damianjarczok/Wzmacniacz-klasy-D-z-modulem-BT/20231201_183953.jpg

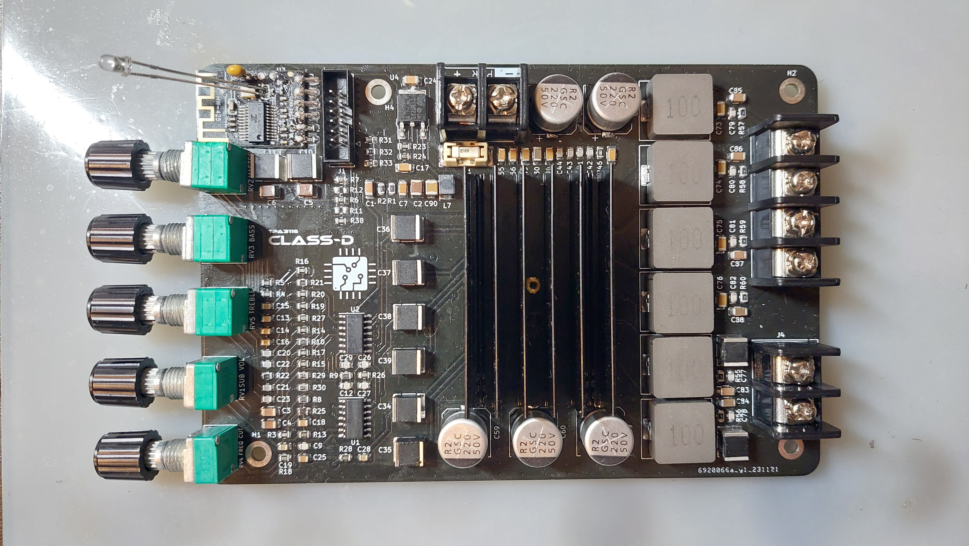
20231201_183953.jpg
