damianjarczok/Wzmacniacz-klasy-D-z-modulem-BT/20231205_011423.jpg

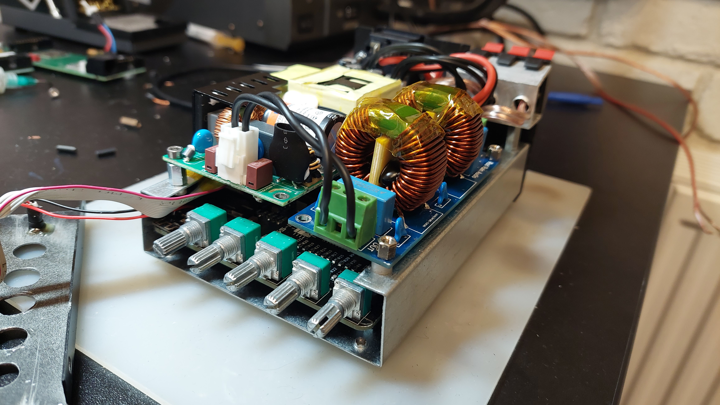
20231205_011423.jpg
