damianjarczok/Wzmacniacz-klasy-D-z-modulem-BT/Wzmacniacz B.png

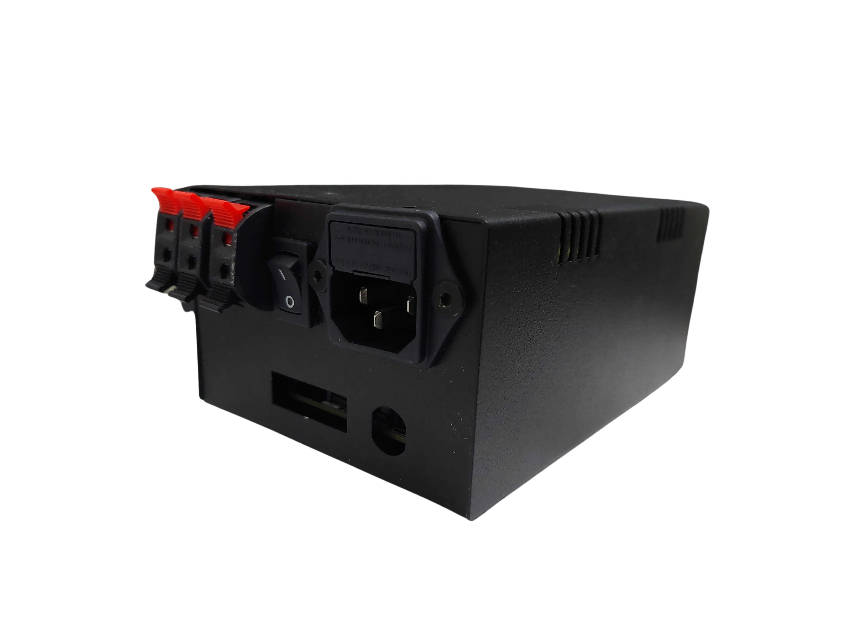
Wzmacniacz B.png
