damianjarczok/Wzmacniacz-klasy-D-z-modulem-BT/Wzmacniacz F.png

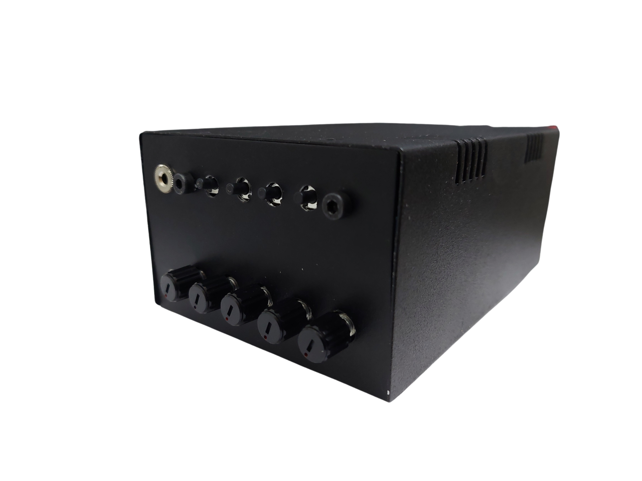
Wzmacniacz F.png
