damianjarczok/Wzmacniacz-klasy-D-z-modulem-BT/Moduł wzmacniacza.kicad_pcb

## KiCad design Moduł wzmacniacza.kicad_pcb (2025-08-06)

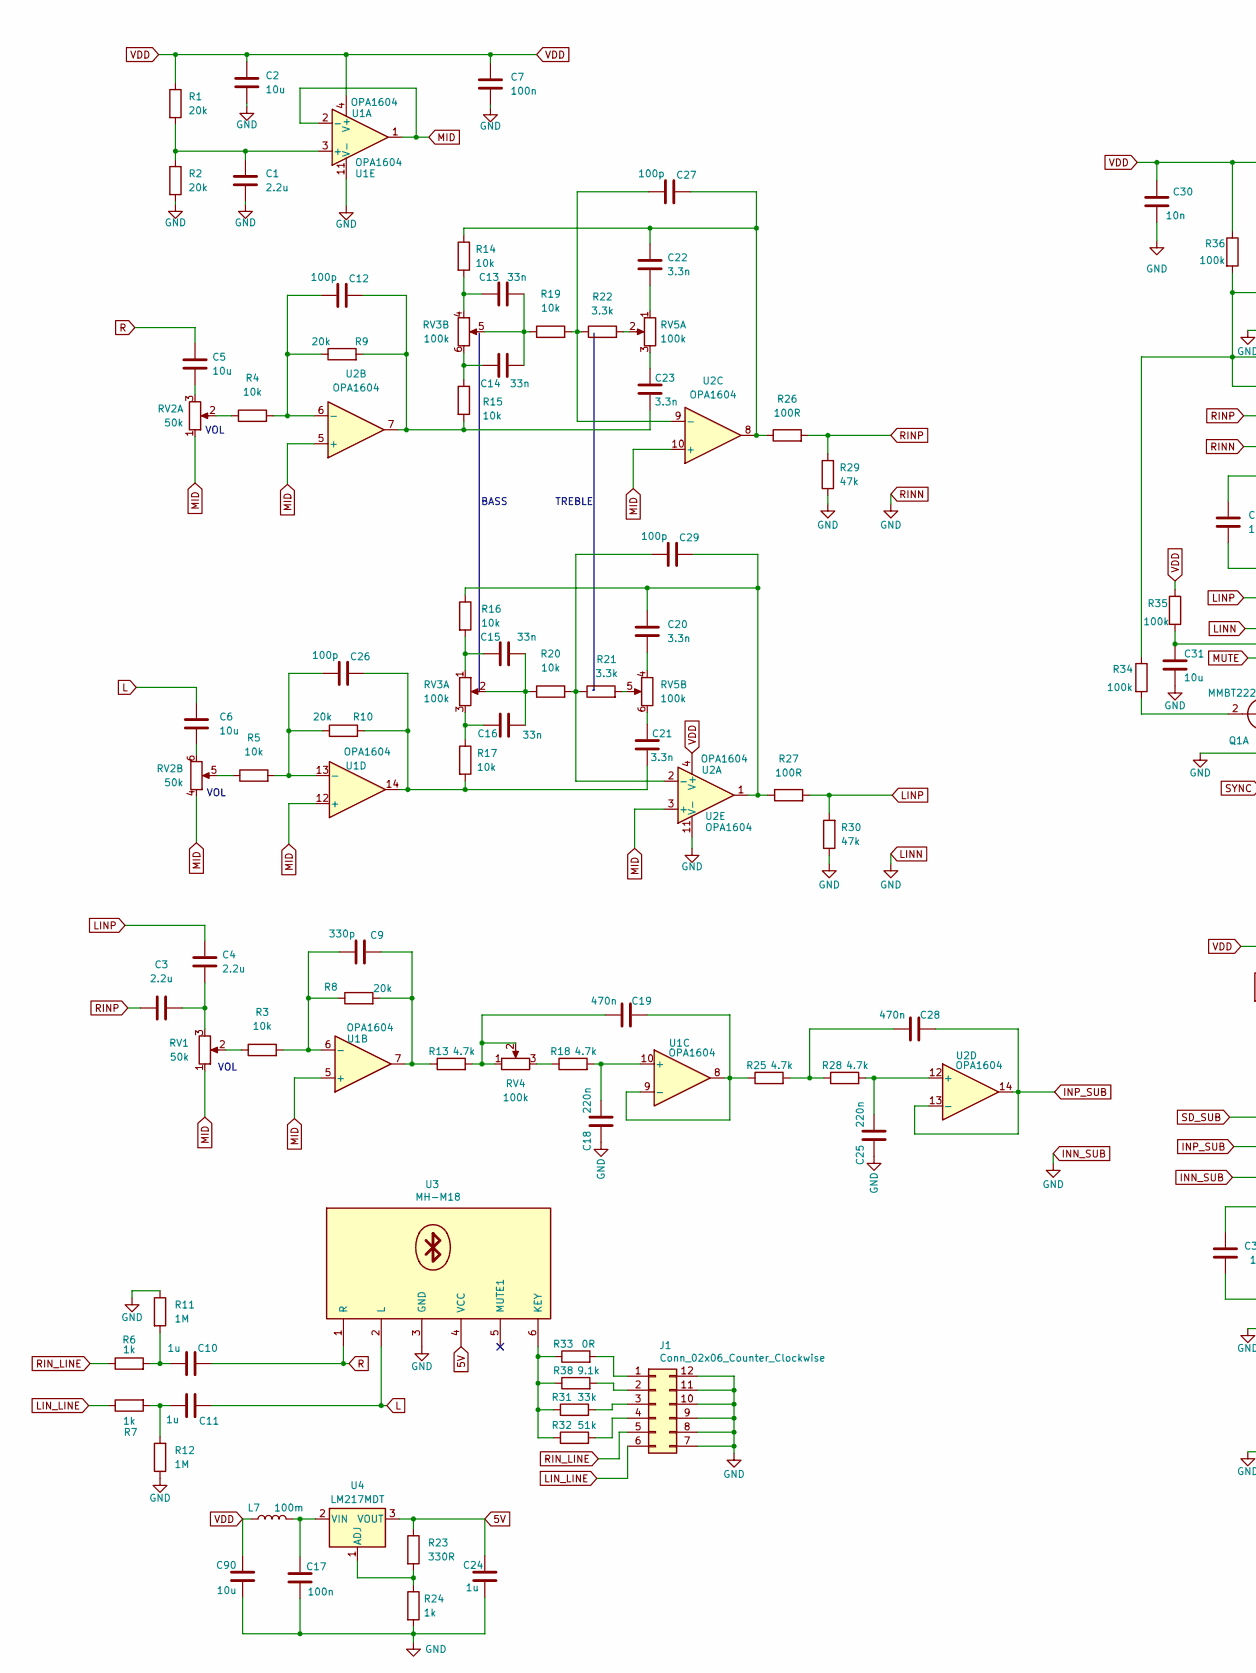
[picture p36: schematic Moduł wzmacniacza.kicad_sch, Wzmacniacz TPA3116, part in row 1, column 1]

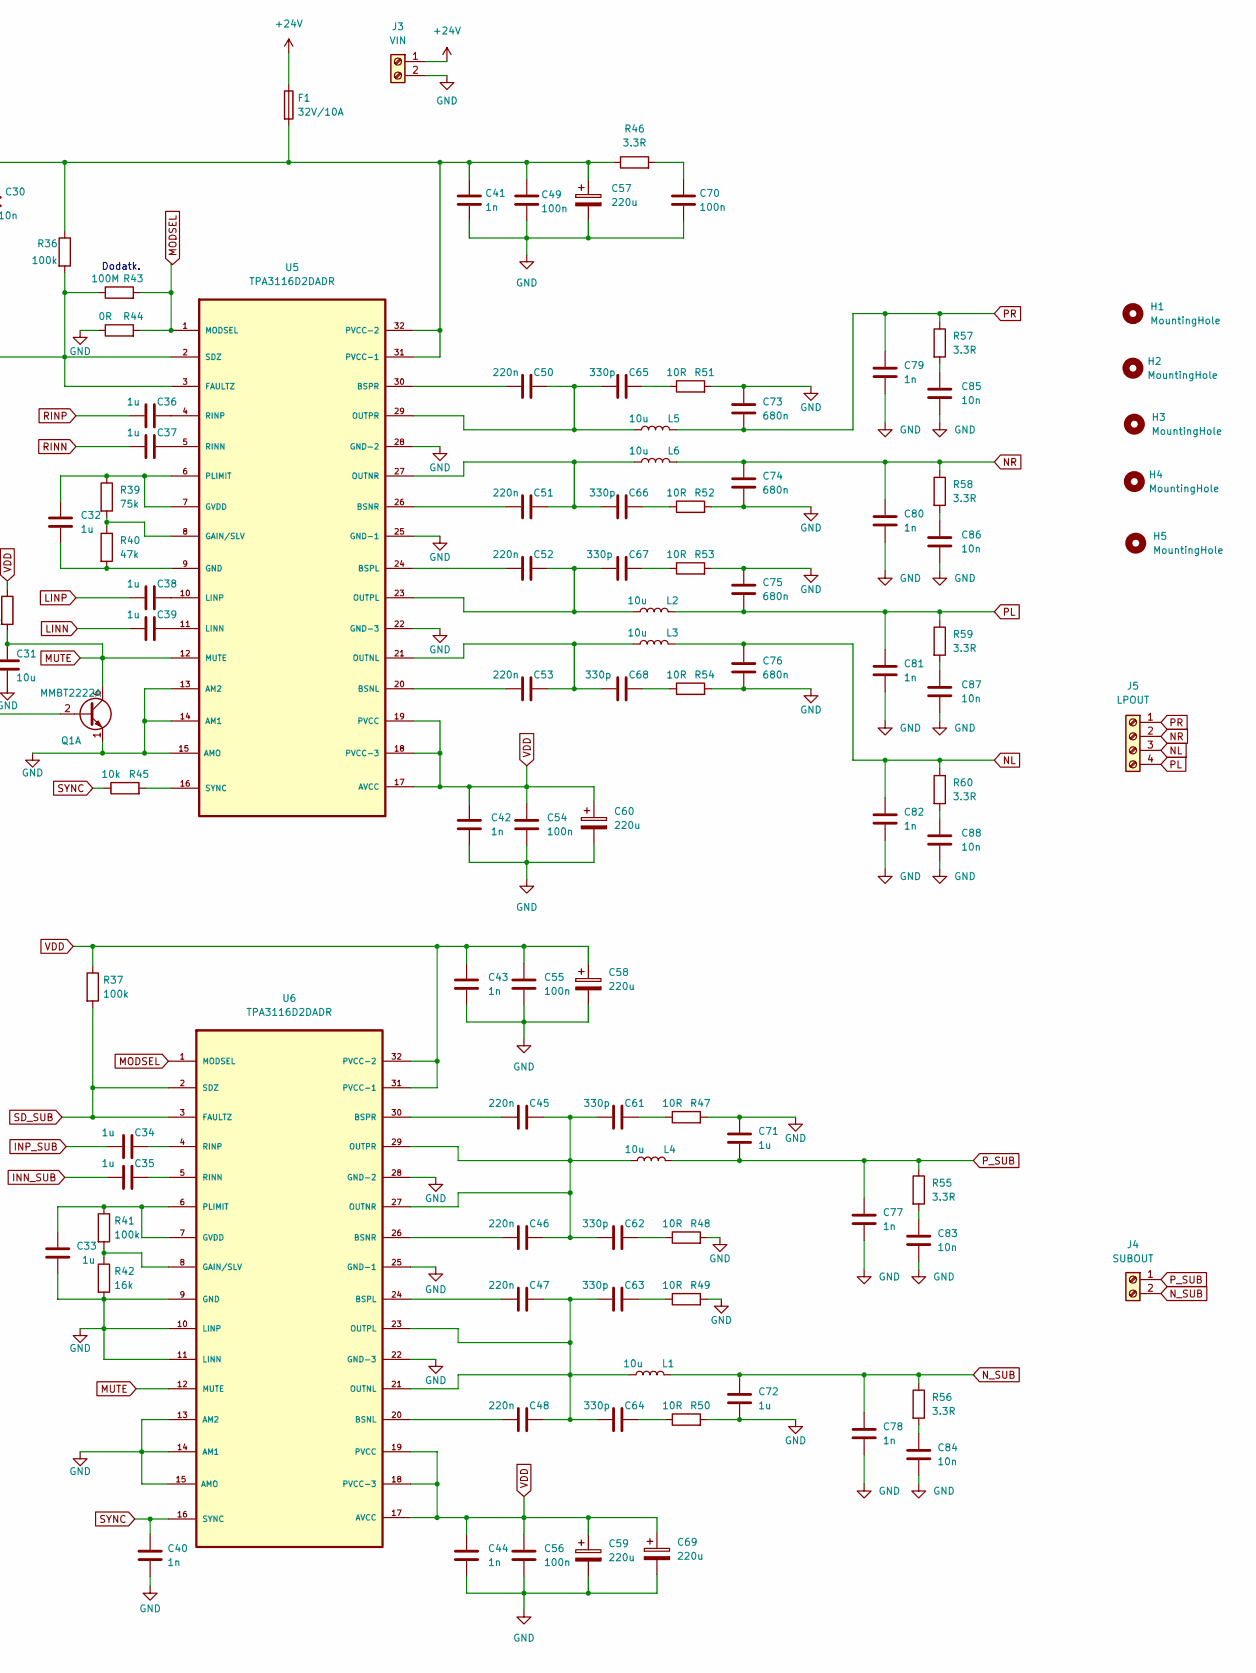
[picture p37: schematic Moduł wzmacniacza.kicad_sch, Wzmacniacz TPA3116, part in row 1, column 2]

Parts:
C1, C3, C4: 2.2u; C_1206_3216Metric
C2, C5, C6, C31: 10u; C_1210_3225Metric
C7, C17, C49, C54, C55, C56, C70: 100n; C_1206_3216Metric
C9, C61, C62, C63, C64, C65, C66, C67, C68: 330p; C_0805_2012Metric
C10, C11, C34, C35, C36, C37, C38, C39, C71, C72: 1u; C_2220_5650Metric
C12, C26, C27, C29: 100p; C_0805_2012Metric
C13, C14, C15, C16: 33n; C_0805_2012Metric
C18, C25, C45, C46, C47, C48, C50, C51, C52, C53: 220n; C_0805_2012Metric
C19, C28: 470n; C_0805_2012Metric
C20, C21, C22, C23: 3.3n; C_0805_2012Metric
C24, C32, C33: 1u; C_1206_3216Metric
C30, C83, C84, C85, C86, C87, C88: 10n; C_1206_3216Metric
C40, C41, C42, C43, C44, C77, C78, C79, C80, C81, C82: 1n; C_0805_2012Metric
C57, C58, C59, C60, C69: 220u; CP_Elec_10x10
C73, C74, C75, C76: 680n; C_1206_3216Metric
C90: 10u; C_1206_3216Metric
F1: 32V/10A; Fuse
H1, H2, H3, H4, H5: MountingHole; MountingHole_3.2mm_M3_DIN965_Pad
J1: Conn_02x06_Counter_Clockwise; IDC-Header_2x06_P2.54mm_Vertical
J3: VIN; Screw 2
J4: SUBOUT; Screw 2
J5: LPOUT; Screw 4
L1, L2, L3, L4, L5, L6: 10u; Dlawik
L7: 100m; L_1812_4532Metric
Q1: MMBT2222A; SOT-23
R1, R2, R8, R9, R10: 20k; R_0805_2012Metric
R3, R4, R5, R14, R15, R16, R17, R19, R20, R45: 10k; R_0805_2012Metric
R6, R7, R24: 1k; R_0805_2012Metric
R11, R12: 1M; R_0805_2012Metric
R13, R18, R25, R28: 4.7k; R_0805_2012Metric
R21, R22: 3.3k; R_0805_2012Metric
R23: 330R; R_0805_2012Metric
R26, R27: 100R; R_0805_2012Metric
R29, R30, R40: 47k; R_0805_2012Metric
R31: 33k; R_0805_2012Metric
R32: 51k; R_0805_2012Metric
R33, R44: 0R; R_0805_2012Metric
R34, R35, R36, R37, R41: 100k; R_0805_2012Metric
R38: 9.1k; R_0805_2012Metric
R39: 75k; R_0805_2012Metric
R42: 16k; R_0805_2012Metric
R43: 100M; R_0805_2012Metric
R46, R55, R56, R57, R58, R59, R60: 3.3R; R_0805_2012Metric
R47, R48, R49, R50, R51, R52, R53, R54: 10R; R_0805_2012Metric
RV1: 50k; Pot single
RV2: 50k; Pot dual
RV3, RV5: 100k; Pot dual
RV4: 100k; Pot single
U1, U2: OPA1604; SOIC-14_3.9x8.7mm_P1.27mm
U3: MH-M18; BM20
U4: LM217MDT; TO-252-2
U5, U6: TPA3116D2DADR; HTSSOP-32-1EP_6.1x11mm_P0.65mm_EP5.2x11mm_Mask4.11x4.36mm

Connections:
5V: C24.1, R23.1, U3.4 (VCC), U4.3 (VOUT)
+24V: F1.1, J3.1
INN_SUB: C1.2, C2.2, C7.2, C17.2, C18.1, C24.2, C25.1, C30.2, C31.2, C33.2, C35.1, C37.1, C39.1, C40.2, C41.2, C42.2, C43.2, C44.2, C49.2, C54.2, C55.2, C56.2, C57.2, C58.2, C59.2, C60.2, C69.2, C70.2, C71.1, C72.2, C73.1, C74.2, C75.1, C76.2, C77.2, C78.2, C79.2, C80.2, C81.2, C82.2, C83.2, C84.2, C85.2, C86.2, C87.2, C88.2, C90.2, H1.1, H2.1, H3.1, H4.1, H5.1, J1.7, J1.8, J1.9, J1.10, J1.11, J1.12, J3.2, Q1.1 (E1), R2.2, R11.1, R12.1, R24.2, R29.1, R30.1, R42.2, R44.1, R47.2, R48.2, R49.2, R50.2, R51.2, R52.2, R53.2, R54.2, U1.11 (V-), U2.11 (V-), U3.3 (GND), U5.13 (AM2), U5.14 (AM1), U5.15 (AMO), U5.22 (GND-3), U5.25 (GND-1), U5.28 (GND-2), U5.33, U6.9 (GND), U6.10 (LINP), U6.11 (LINN), U6.13 (AM2), U6.14 (AM1), U6.15 (AMO), U6.22 (GND-3), U6.25 (GND-1), U6.28 (GND-2), U6.33
INP_SUB: C28.2, C34.1, U2.13 (-), U2.14
L: C6.1, C11.2, U3.2 (L)
LINP: C4.1, C38.1, R27.2, R30.2
LIN_LINE: J1.6, R7.1
MID: RV1.1, RV2.1, RV2.4, U1.1, U1.2 (-), U1.5 (+), U1.12 (+), U2.3 (+), U2.5 (+), U2.10 (+)
MODSEL: R43.2, R44.2, U5.1 (MODSEL), U6.1 (MODSEL)
MUTE: C31.1, Q1.6 (C1), R35.2, U5.12 (MUTE), U6.12 (MUTE)
NL: C76.1, C82.1, J5.3, L3.2, R60.1
NR: C74.1, C80.1, J5.2, L6.2, R58.1
N_SUB: C72.1, C78.1, J4.2, L1.2, R56.1
unnamed: C1.1, R1.2, R2.1, U1.3 (+)
unnamed: C3.2, C4.2, RV1.3
unnamed: C5.2, RV2.3
unnamed: C6.2, RV2.6
unnamed: C9.1, R3.2, R8.1, U1.6 (-)
unnamed: C9.2, R8.2, R13.1, U1.7
unnamed: C10.1, R6.2, R11.2
unnamed: C11.1, R7.2, R12.2
unnamed: C12.1, R4.2, R9.1, U2.6 (-)
unnamed: C12.2, C23.2, R9.2, R15.2, U2.7
unnamed: C13.1, R14.2, RV3.4
unnamed: C13.2, C14.2, R19.1, RV3.5
unnamed: C14.1, R15.1, RV3.6
unnamed: C15.1, R16.2, RV3.1
unnamed: C15.2, C16.2, R20.1, RV3.2
unnamed: C16.1, R17.1, RV3.3
unnamed: C17.1, L7.1, U4.2 (VIN)
unnamed: C18.2, R18.2, U1.10 (+)
unnamed: C19.1, R13.2, RV4.1, RV4.2
unnamed: C19.2, R25.1, U1.8, U1.9 (-)
unnamed: C20.1, C29.2, R16.1, R27.1, U2.1
unnamed: C20.2, RV5.4
unnamed: C21.1, RV5.6
unnamed: C21.2, C26.2, R10.2, R17.2, U1.14
unnamed: C22.1, C27.2, R14.1, R26.1, U2.8
unnamed: C22.2, RV5.1
unnamed: C23.1, RV5.3
unnamed: C25.2, R28.2, U2.12 (+)
unnamed: C26.1, R5.2, R10.1, U1.13 (-)
unnamed: C27.1, R19.2, R22.1, U2.9 (-)
unnamed: C28.1, R25.2, R28.1
unnamed: C29.1, R20.2, R21.1, U2.2 (-)
unnamed: C32.1, R39.1, U5.6 (PLIMIT), U5.7 (GVDD)
unnamed: C32.2, R40.2, U5.9 (GND)
unnamed: C33.1, R41.1, U6.6 (PLIMIT), U6.7 (GVDD)
unnamed: C34.2, U6.4 (RINP)
unnamed: C35.2, U6.5 (RINN)
unnamed: C36.2, U5.4 (RINP)
unnamed: C37.2, U5.5 (RINN)
unnamed: C38.2, U5.10 (LINP)
unnamed: C39.2, U5.11 (LINN)
unnamed: C45.1, U6.30 (BSPR)
unnamed: C45.2, C46.2, C61.1, C62.1, L4.1, U6.27 (OUTNR), U6.29 (OUTPR)
unnamed: C46.1, U6.26 (BSNR)
unnamed: C47.1, U6.24 (BSPL)
unnamed: C47.2, C48.2, C63.1, C64.1, L1.1, U6.21 (OUTNL), U6.23 (OUTPL)
unnamed: C48.1, U6.20 (BSNL)
unnamed: C50.1, U5.30 (BSPR)
unnamed: C50.2, C65.1, L5.1, U5.29 (OUTPR)
unnamed: C51.1, U5.26 (BSNR)
unnamed: C51.2, C66.1, L6.1, U5.27 (OUTNR)
unnamed: C52.1, U5.24 (BSPL)
unnamed: C52.2, C67.1, L2.1, U5.23 (OUTPL)
unnamed: C53.1, U5.20 (BSNL)
unnamed: C53.2, C68.1, L3.1, U5.21 (OUTNL)
unnamed: C61.2, R47.1
unnamed: C62.2, R48.1
unnamed: C63.2, R49.1
unnamed: C64.2, R50.1
unnamed: C65.2, R51.1
unnamed: C66.2, R52.1
unnamed: C67.2, R53.1
unnamed: C68.2, R54.1
unnamed: C70.1, R46.2
unnamed: C83.1, R55.2
unnamed: C84.1, R56.2
unnamed: C85.1, R57.2
unnamed: C86.1, R58.2
unnamed: C87.1, R59.2
unnamed: C88.1, R60.2
unnamed: J1.1, R33.2
unnamed: J1.2, R38.2
unnamed: J1.3, R31.2
unnamed: J1.4, R32.2
unnamed: Q1.2 (B1), R34.2
unnamed: R3.1, RV1.2
unnamed: R4.1, RV2.2
unnamed: R5.1, RV2.5
unnamed: R18.1, RV4.3
unnamed: R21.2, RV5.5
unnamed: R22.2, RV5.2
unnamed: R23.2, R24.1, U4.1 (ADJ)
unnamed: R31.1, R32.1, R33.1, R38.1, U3.6 (KEY)
unnamed: R34.1, R36.2, R43.1, U5.2 (SDZ), U5.3 (FAULTZ)
unnamed: R39.2, R40.1, U5.8 (GAIN/SLV)
unnamed: R41.2, R42.1, U6.8 (GAIN/SLV)
unnamed: R45.2, U5.16 (SYNC)
PL: C75.2, C81.1, J5.4, L2.2, R59.1
PR: C73.2, C79.1, J5.1, L5.2, R57.1
P_SUB: C71.2, C77.1, J4.1, L4.2, R55.1
R: C5.1, C10.2, U3.1 (R)
RINP: C3.1, C36.1, R26.2, R29.2
RIN_LINE: J1.5, R6.1
SD_SUB: R37.2, U6.2 (SDZ), U6.3 (FAULTZ)
SYNC: C40.1, R45.1, U6.16 (SYNC)
VDD: C2.1, C7.1, C30.1, C41.1, C42.1, C43.1, C44.1, C49.1, C54.1, C55.1, C56.1, C57.1, C58.1, C59.1, C60.1, C69.1, C90.1, F1.2, L7.2, R1.1, R35.1, R36.1, R37.1, R46.1, U1.4 (V+), U2.4 (V+), U5.17 (AVCC), U5.18 (PVCC-3), U5.19 (PVCC), U5.31 (PVCC-1), U5.32 (PVCC-2), U6.17 (AVCC), U6.18 (PVCC-3), U6.19 (PVCC), U6.31 (PVCC-1), U6.32 (PVCC-2)

Notes on the sheet:
VOL
TREBLE
Dodatk.
BASS

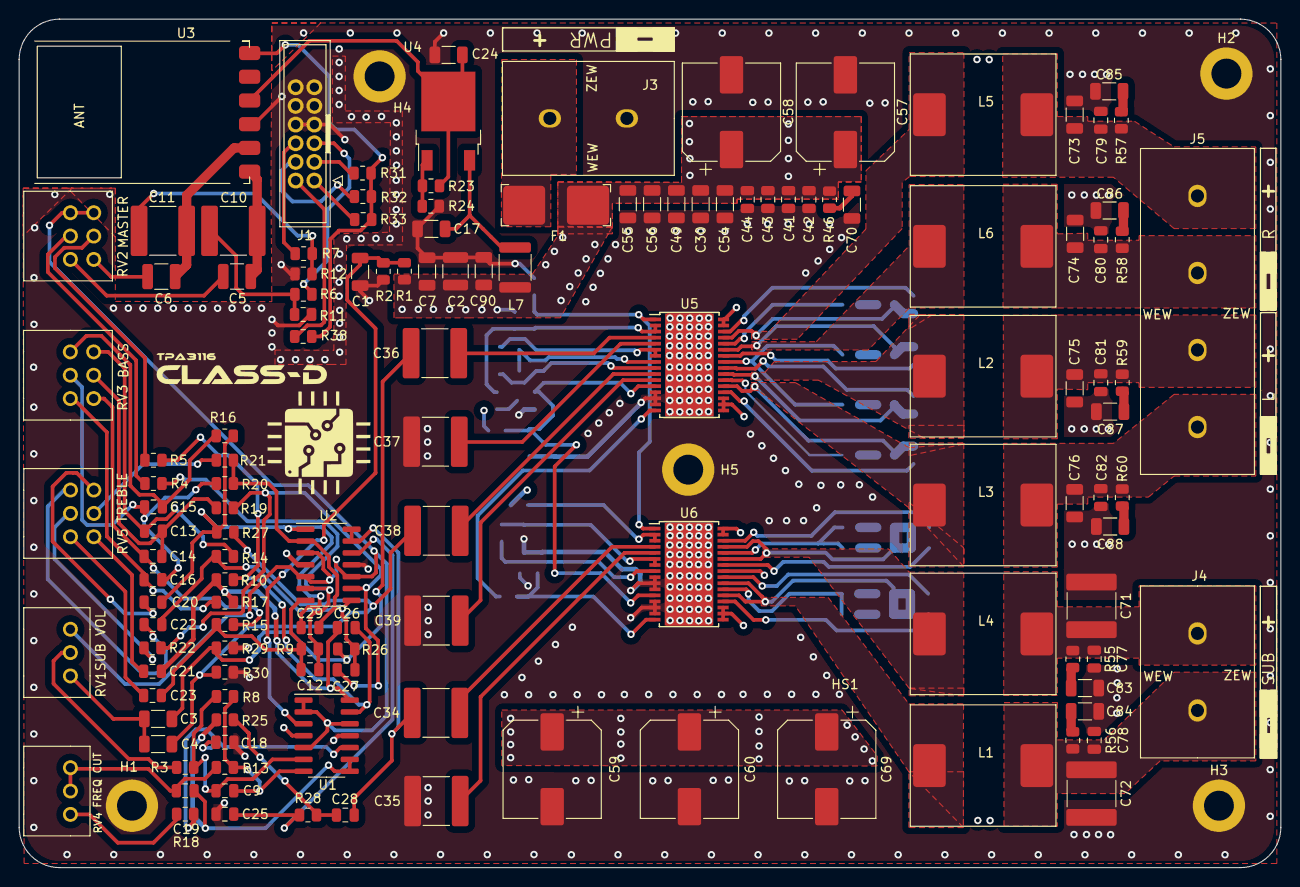
[picture p38: board Moduł wzmacniacza.kicad_pcb from above]

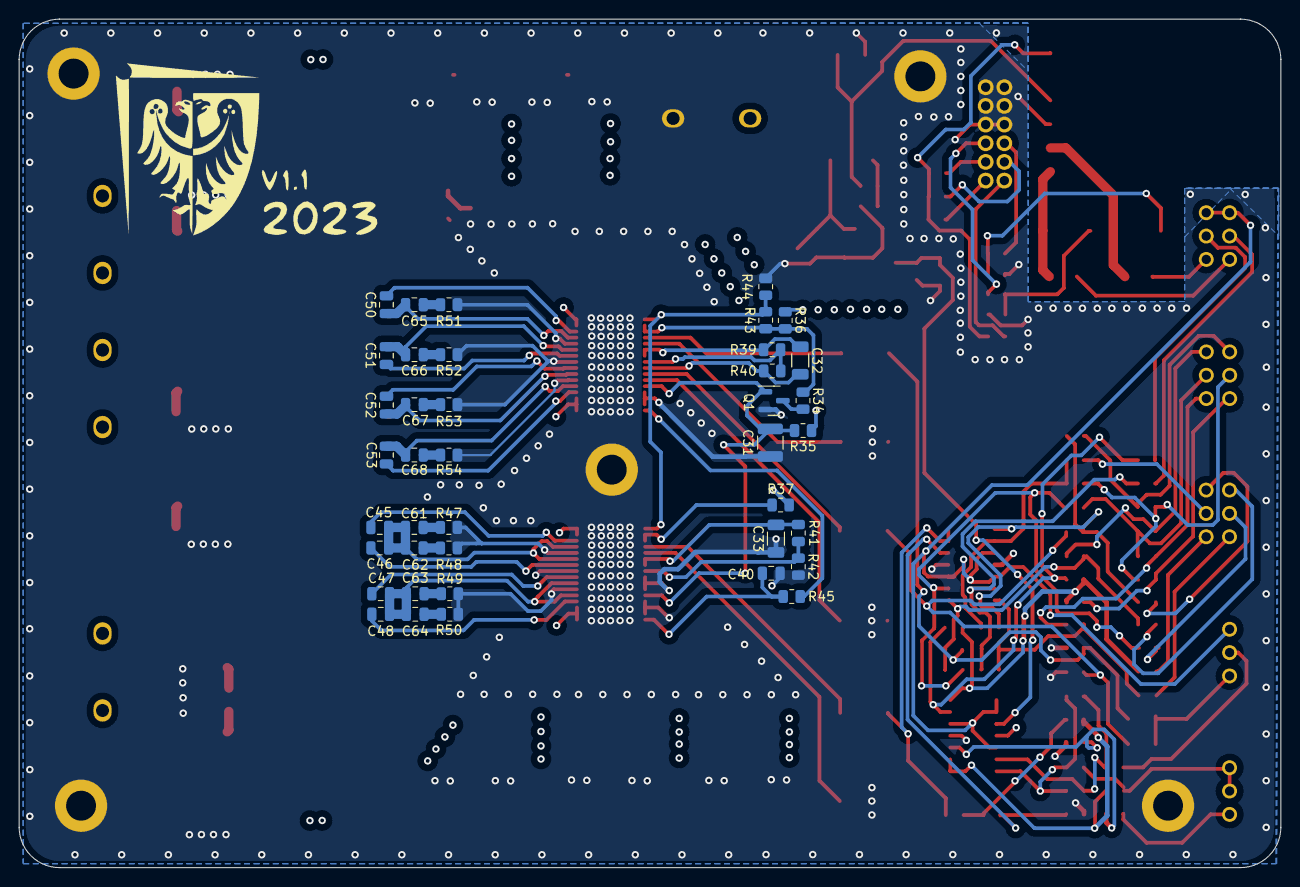
[picture p39: board Moduł wzmacniacza.kicad_pcb from below]

Board: 4 copper layers, 135.1 x 90.9 mm, 177 parts (40 on the bottom side), 109 nets.
